readysetstem/readysetstem-hw-lids/HeaderConnectorBoard/board-bottom.jpg

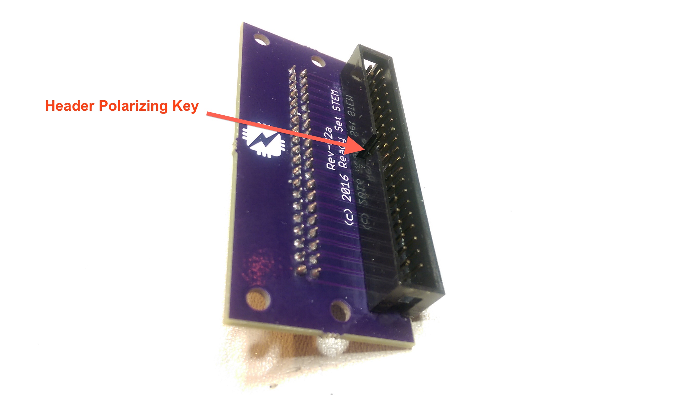
HeaderConnectorBoard/board-bottom.jpg
