readysetstem/readysetstem-hw-lids/HeaderConnectorBoard/board-top.jpg

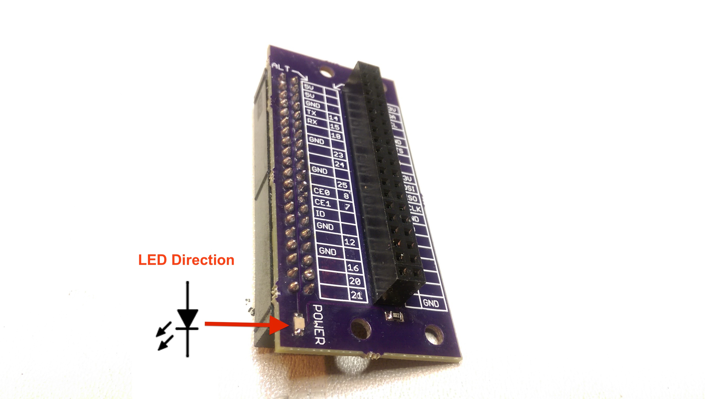
HeaderConnectorBoard/board-top.jpg
