readysetstem/readysetstem-hw-lids/README.md

readysetstem-hw-lids
===========================

Ready Set STEM(TM) Lids hardware schematics and related documents
