readysetstem/readysetstem-hw-lids/MiniConnectorBoard/README.txt

FILE LIST

gerbers/*.GKO       Outline
gerbers/*.GBL       Bottom Copper
gerbers/*.GBO       Bottom Silkscreen
gerbers/*.GBP       Bottom Paste
gerbers/*.GBS       Bottom Soldermask
gerbers/*.GTL       Top Copper
gerbers/*.GTO       Top Silkscreen
gerbers/*.GTP       Top Paste
gerbers/*.GTS       Top Soldermask
gerbers/*.GML       Mill Layer
gerbers/*.TXT       Drill File
gerbers/*.dri       Drill Station Info File
gerbers/*.gpi       Photoplotter Info File   
*.brd               EagleCAD Board File
*.lbr               EagleCAD Library File
*.sch               EagleCAD Schematic File
*_BOM.xls           BOM
README.txt          This file
*.jpg               Reference images

Gerber Files Generated from EagleCAD 7.6 CAM Processor using sfe-gerb274x.cam

GENERAL NOTES

- Refer to the JPG images for through-hole part orientation.
- All parts and assembly should be Lead-Free RoHS compliant
- Any manufacturer information added to silkscreen should be on bottom side of
  board only.

BOARD SPECS

Material                FR4
Board Thickness         62 mils
Layers                  2
Copper thickness        1 oz.
Silkscreen color        white
Soldermask color        green
Finish                  Lead Free HASL or ENIG
Panelization            V-cut

CONTACT INFO

Name                    Brian Silverman or Jason Steinhorn
Company                 Ready Set STEM
Email                   bri@readysetstem.com or j@readysetstem.com
