readysetstem/readysetstem-hw-lids/MiniConnectorBoard/MiniConnectorBoard_BOM.xls

Item | Qty | Reference Designators | Internal Part # | Manufacturer | Manufacturer Part # | Digikey Part # | Value | Package | Description
1 | 1 | JP1 | rs06036 | Sullins Connector Solutions | PPTC202LFBN-RC | S6104-ND | NA | Thru hole | CONN HEADER FEM 40POS .1" DL TIN
2 | 2 | JP2 JP3 | rs06033 | Sullins Connector Solutions | PPTC201LFBN-RC | S7018-ND | NA | Thru hole | CONN HEADER FEMALE 20POS.1" TIN
