readysetstem/readysetstem-hw-lids/Gamer/Gamer_BOM.xls

Item | Qty | Reference Designators | Internal Part # | Manufacturer | Manufacturer Part # | Digikey Part # | Value | Package | Description
1 | 8 | J1 J2 J3 J4 J5 J6 J7 J8 | rs06057 | Sullins | PPTC081LFBN-RC | S7006-ND |  | Thru hole | CONN HEADER FEMALE 8POS .1" TIN
2 | 4 | R1 R2 R3 R4 R5 R6 | rs06006 | Yageo | RC0603JR-0710KL | 311-10KGRCT-ND | 10kohms | 0603 | RES SMD 10K OHM 5% 1/10W 0603
3 | 4 | U2 U4 U6 U8 | rs06053 | Atmel | ATTINY48-AUR | ATTINY48-AURCT-ND |  | 32-TQFP | IC MCU 8BIT 4KB FLASH 32TQFP
4 | 4 | U3 U5 U7 U9 | rs06052 | Toshiba Semiconductor | ULN2803AFWG,C,EL | ULN2803AFWGCELTR-ND |  | 18-SOIC | TRANS 8NPN DARL 50V 0.5A 18SOL
5 | 1 | U1 | rs06007 | Freescale Semiconductor | MMA8653FCR1 | MMA8653FCR1TR-ND |  | 10-VFDFN | IC ACCELEROMETER 3AXIS 10DFN
7 | 3 | C1 C3 C4 | rs06004 | Murata | GRM188R71C104KA01D | 490-1532-1-ND | 0.1µF | 0603 | CAP CER 0.1UF 16V 10% X7R 0603
8 | 1 | C2 C5 C6 C7 C8 | rs06005 | Murata | GRM188R61A105KA61D | 490-1543-1-ND | 1µF | 0603 | CAP CER 1UF 10V 10% X5R 0603
9 | 1 | J9 | rs06037 | On Shore Technology Inc | 302-S401 | ED10529-ND |  | Thru hole | CONN HEADER VERT 40POS GOLD
10 | 6 | B3 B4 B5 B6 B7 B8 | rs04017 | E-Switch | TL3300DF260Q | EG4907CT-ND |  | SMD | SWITCH TACTILE SPST-NO 0.05A 12V
11 | 2 | B1 B2 | rs04016 | C&K Components | PTS645SK43SMTR92 LFS | CKN9084CT-ND |  | SMD | SWITCH TACTILE SPST-NO 0.05A 12V
