readysetstem/readysetstem-hw-lids/MiniConnectorBoard/MiniConnectorBoard.brd

## EAGLE design MiniConnectorBoard/MiniConnectorBoard.brd (2016-09-28)

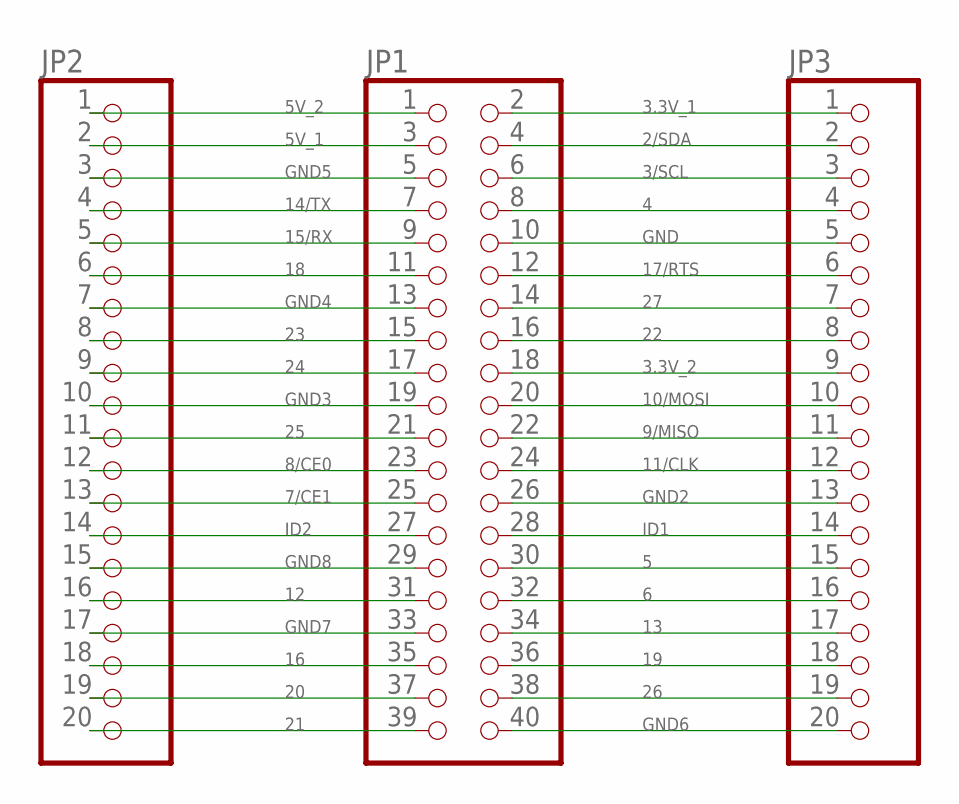
[picture p3: schematic MiniConnectorBoard.sch]

Parts:
JP1: NONE; 2X20
JP2, JP3: NONE; 1X20

Connections:
2/SDA: JP1.4, JP3.2
3.3V_1: JP1.2, JP3.1
3.3V_2: JP1.18, JP3.9
3/SCL: JP1.6, JP3.3
4: JP1.8, JP3.4
5: JP1.30, JP3.15
5V_1: JP1.3, JP2.2
5V_2: JP1.1, JP2.1
6: JP1.32, JP3.16
7/CE1: JP1.25, JP2.13
8/CE0: JP1.23, JP2.12
9/MISO: JP1.22, JP3.11
10/MOSI: JP1.20, JP3.10
11/CLK: JP1.24, JP3.12
12: JP1.31, JP2.16
13: JP1.34, JP3.17
14/TX: JP1.7, JP2.4
15/RX: JP1.9, JP2.5
16: JP1.35, JP2.18
17/RTS: JP1.12, JP3.6
18: JP1.11, JP2.6
19: JP1.36, JP3.18
20: JP1.37, JP2.19
21: JP1.39, JP2.20
22: JP1.16, JP3.8
23: JP1.15, JP2.8
24: JP1.17, JP2.9
25: JP1.21, JP2.11
26: JP1.38, JP3.19
27: JP1.14, JP3.7
GND: JP1.10, JP3.5
GND2: JP1.26, JP3.13
GND3: JP1.19, JP2.10
GND4: JP1.13, JP2.7
GND5: JP1.5, JP2.3
GND6: JP1.40, JP3.20
GND7: JP1.33, JP2.17
GND8: JP1.29, JP2.15
ID1: JP1.28, JP3.14
ID2: JP1.27, JP2.14

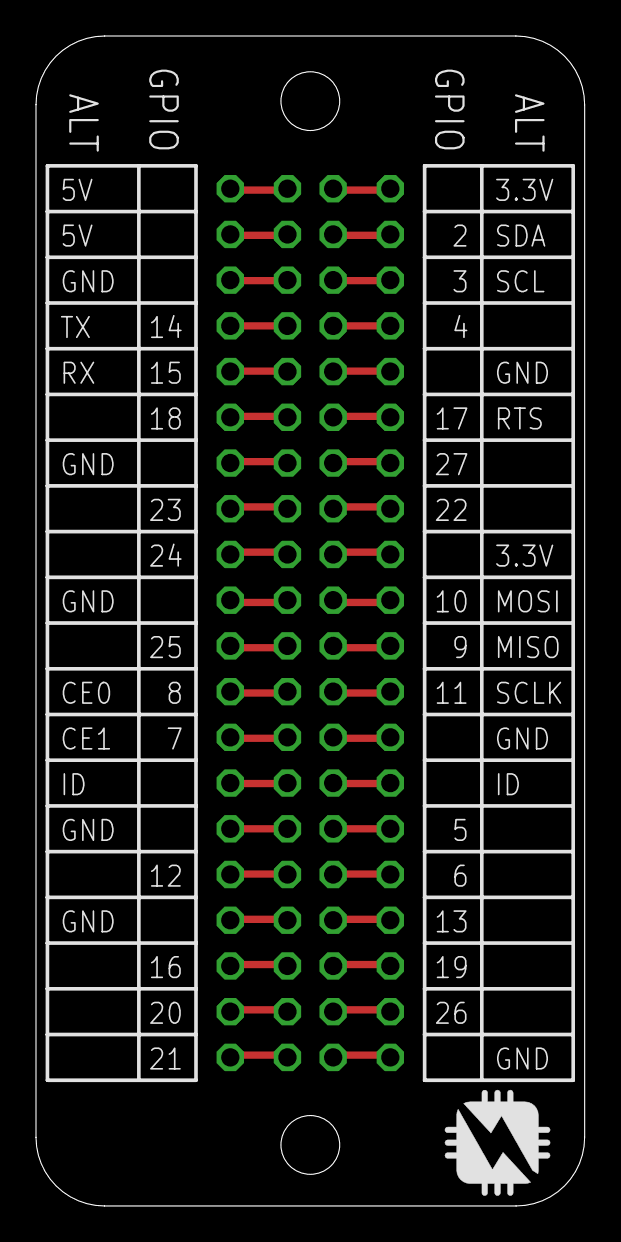
[picture p4: board MiniConnectorBoard.brd from above]

Board: 2 copper layers, 30.5 x 65.0 mm, 3 parts (0 on the bottom side), 40 nets.
