readysetstem/readysetstem-hw-lids/Gamer/Gamer.brd

## EAGLE design Gamer/Gamer.brd (2015-05-13)

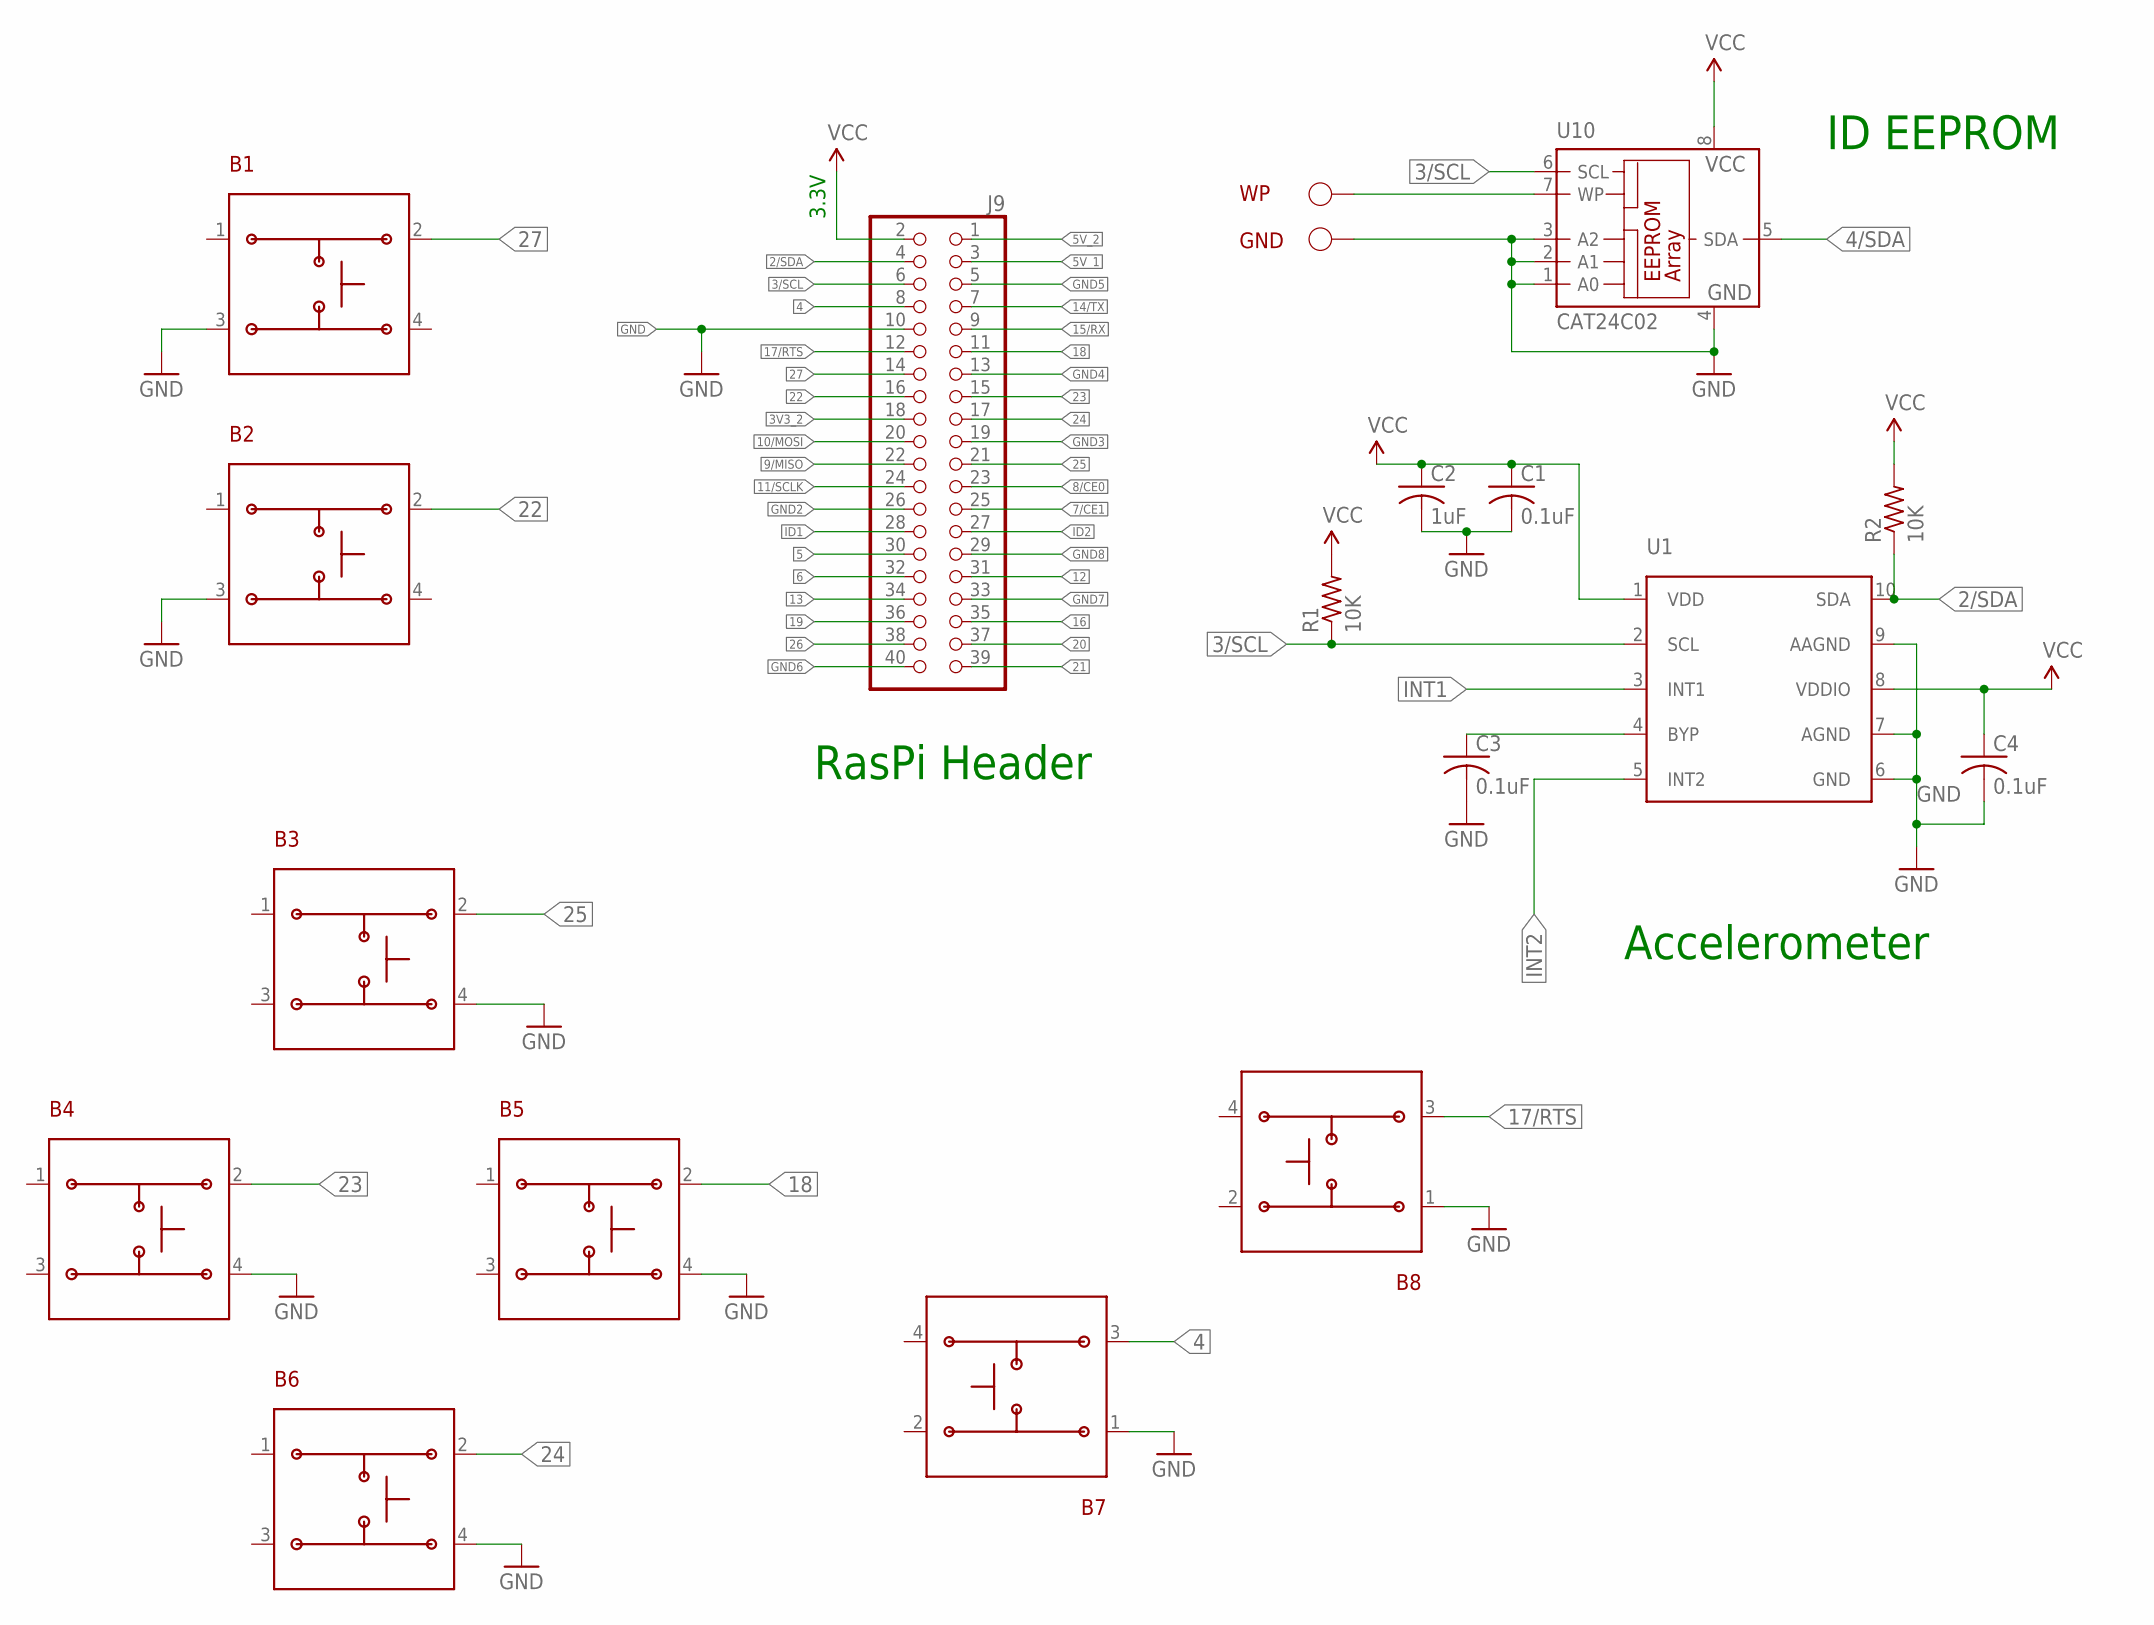
[picture p5: schematic Gamer.sch, sheet 1]

Parts:
B1, B2: 6X6MM_BUTTON
B3, B4, B5, B6, B7, B8: 12X12MM_BUTTON
C1, C3, C4: 0.1uF; C0603
C2: 1uF; C0603
GND: TESTPAD
J9: PINHD-2X20; 2X20
R1, R2: 10K; R0603
U1: MMA8653FCR1
U10: CAT24C02; TSSOP8
WP: TESTPAD

Connections:
2/SDA: J9.4, R2.1, U1.10 (SDA)
3/SCL: J9.6, R1.1, U1.2 (SCL), U10.6 (SCL)
3V3_2: J9.18
4: B7.3, J9.8
4/SDA: U10.5 (SDA)
5: J9.30
5V_1: J9.3
5V_2: J9.1
6: J9.32
7/CE1: J9.25
8/CE0: J9.23; also elsewhere on the board
9/MISO: J9.22; also elsewhere on the board
10/MOSI: J9.20; also elsewhere on the board
11/SCLK: J9.24; also elsewhere on the board
12: J9.31
13: J9.34
14/TX: J9.7
15/RX: J9.9
16: J9.35
17/RTS: B8.3, J9.12
18: B5.2, J9.11
19: J9.36
20: J9.37
21: J9.39
22: B2.2, J9.16
23: B4.2, J9.15
24: B6.2, J9.17
25: B3.2, J9.21
26: J9.38
27: B1.2, J9.14
GND: B1.3, B2.3, B3.4, B4.4, B5.4, B6.4, B7.1, B8.1, C1.2, C2.2, C3.2, C4.2, GND.1, J9.10, U1.6 (GND), U1.7 (AGND), U1.9 (AAGND), U10.1 (A0), U10.2 (A1), U10.3 (A2), U10.4 (GND); also elsewhere on the board
GND2: J9.26
GND3: J9.19
GND4: J9.13
GND5: J9.5
GND6: J9.40
GND7: J9.33
GND8: J9.29
ID1: J9.28
ID2: J9.27
INT1: U1.3 (INT1)
INT2: U1.5 (INT2)
unnamed: U10.7 (WP), WP.1
unnamed: C3.1, U1.4 (BYP)
VCC: C1.1, C2.1, C4.1, J9.2, R1.2, R2.2, U1.1 (VDD), U1.8 (VDDIO), U10.8 (VCC); also elsewhere on the board

Notes on the sheet:
RasPi Header
Accelerometer
3.3V
ID EEPROM

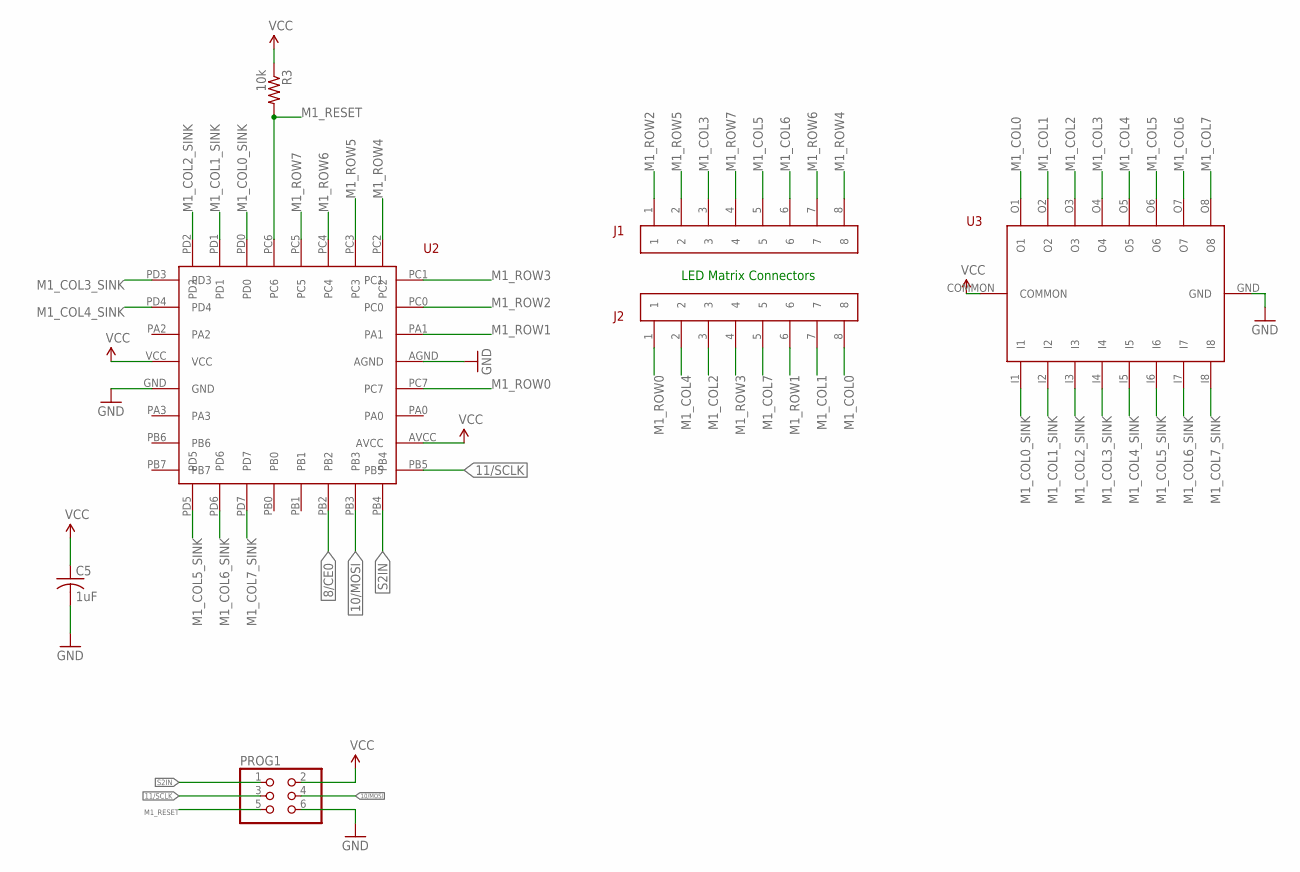
[picture p6: schematic Gamer.sch, sheet 2]

Parts:
C5: 1uF; C0603
J1, J2: HEADER-1X8
PROG1: NONE; 2X03
R3: 10k; R0603
U2: ATTINY48
U3: ULN2803AFWG

Connections:
8/CE0: U2.PB2; also elsewhere on the board
10/MOSI: PROG1.4, U2.PB3; also elsewhere on the board
11/SCLK: PROG1.3, U2.PB5; also elsewhere on the board
GND: C5.2, PROG1.6, U2.AGND, U2.GND, U3.GND; also elsewhere on the board
M1_COL0: J2.8, U3.O1
M1_COL0_SINK: U2.PD0, U3.I1
M1_COL1: J2.7, U3.O2
M1_COL1_SINK: U2.PD1, U3.I2
M1_COL2: J2.3, U3.O3
M1_COL2_SINK: U2.PD2, U3.I3
M1_COL3: J1.3, U3.O4
M1_COL3_SINK: U2.PD3, U3.I4
M1_COL4: J2.2, U3.O5
M1_COL4_SINK: U2.PD4, U3.I5
M1_COL5: J1.5, U3.O6
M1_COL5_SINK: U2.PD5, U3.I6
M1_COL6: J1.6, U3.O7
M1_COL6_SINK: U2.PD6, U3.I7
M1_COL7: J2.5, U3.O8
M1_COL7_SINK: U2.PD7, U3.I8
M1_RESET: PROG1.5, R3.2, U2.PC6
M1_ROW0: J2.1, U2.PC7
M1_ROW1: J2.6, U2.PA1
M1_ROW2: J1.1, U2.PC0
M1_ROW3: J2.4, U2.PC1
M1_ROW4: J1.8, U2.PC2
M1_ROW5: J1.2, U2.PC3
M1_ROW6: J1.7, U2.PC4
M1_ROW7: J1.4, U2.PC5
S2IN: PROG1.1, U2.PB4; also elsewhere on the board
VCC: C5.1, PROG1.2, R3.1, U2.AVCC, U2.VCC, U3.COMMON; also elsewhere on the board

Notes on the sheet:
LED Matrix Connectors

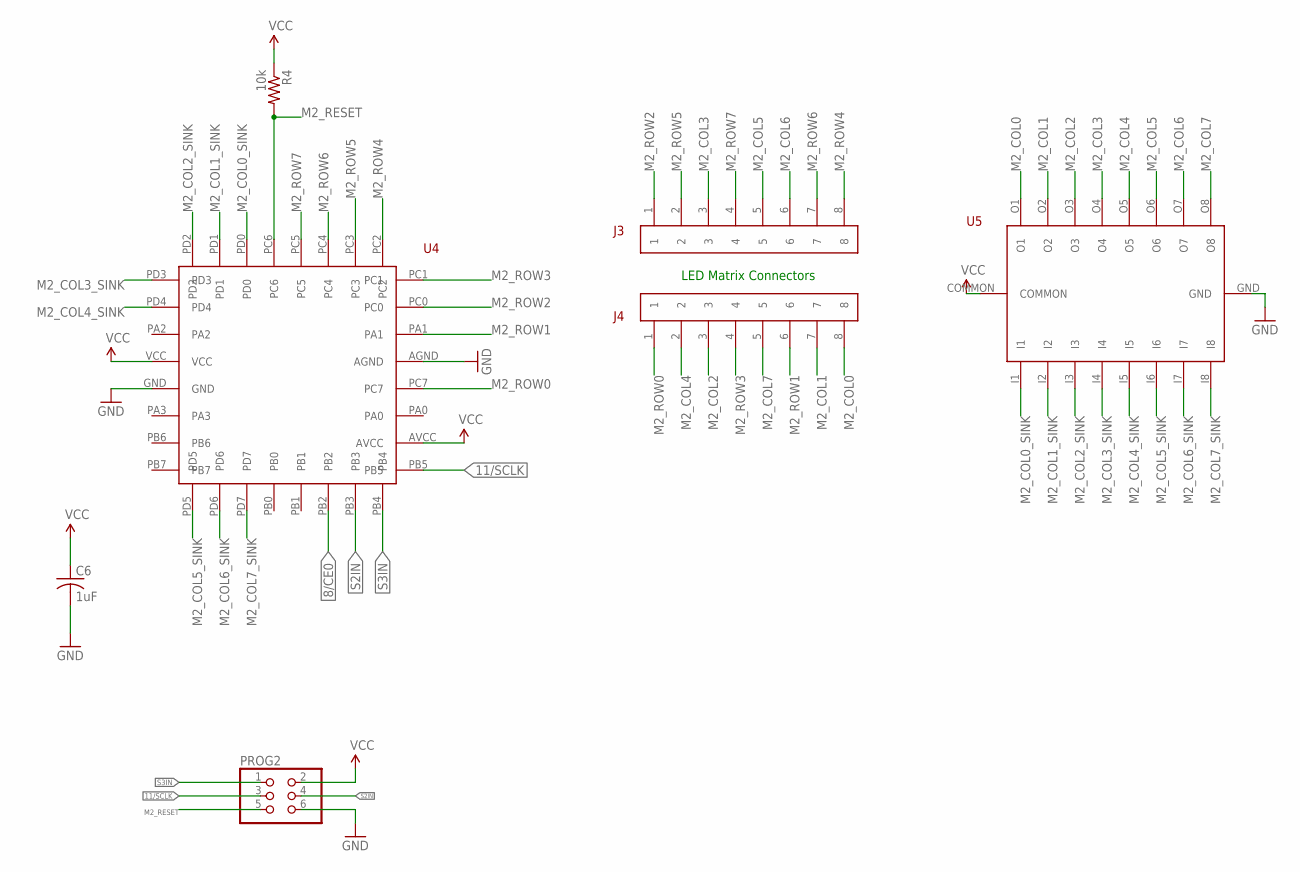
[picture p7: schematic Gamer.sch, sheet 3]

Parts:
C6: 1uF; C0603
J3, J4: HEADER-1X8
PROG2: NONE; 2X03
R4: 10k; R0603
U4: ATTINY48
U5: ULN2803AFWG

Connections:
8/CE0: U4.PB2; also elsewhere on the board
11/SCLK: PROG2.3, U4.PB5; also elsewhere on the board
GND: C6.2, PROG2.6, U4.AGND, U4.GND, U5.GND; also elsewhere on the board
M2_COL0: J4.8, U5.O1
M2_COL0_SINK: U4.PD0, U5.I1
M2_COL1: J4.7, U5.O2
M2_COL1_SINK: U4.PD1, U5.I2
M2_COL2: J4.3, U5.O3
M2_COL2_SINK: U4.PD2, U5.I3
M2_COL3: J3.3, U5.O4
M2_COL3_SINK: U4.PD3, U5.I4
M2_COL4: J4.2, U5.O5
M2_COL4_SINK: U4.PD4, U5.I5
M2_COL5: J3.5, U5.O6
M2_COL5_SINK: U4.PD5, U5.I6
M2_COL6: J3.6, U5.O7
M2_COL6_SINK: U4.PD6, U5.I7
M2_COL7: J4.5, U5.O8
M2_COL7_SINK: U4.PD7, U5.I8
M2_RESET: PROG2.5, R4.2, U4.PC6
M2_ROW0: J4.1, U4.PC7
M2_ROW1: J4.6, U4.PA1
M2_ROW2: J3.1, U4.PC0
M2_ROW3: J4.4, U4.PC1
M2_ROW4: J3.8, U4.PC2
M2_ROW5: J3.2, U4.PC3
M2_ROW6: J3.7, U4.PC4
M2_ROW7: J3.4, U4.PC5
S2IN: PROG2.4, U4.PB3; also elsewhere on the board
S3IN: PROG2.1, U4.PB4; also elsewhere on the board
VCC: C6.1, PROG2.2, R4.1, U4.AVCC, U4.VCC, U5.COMMON; also elsewhere on the board

Notes on the sheet:
LED Matrix Connectors

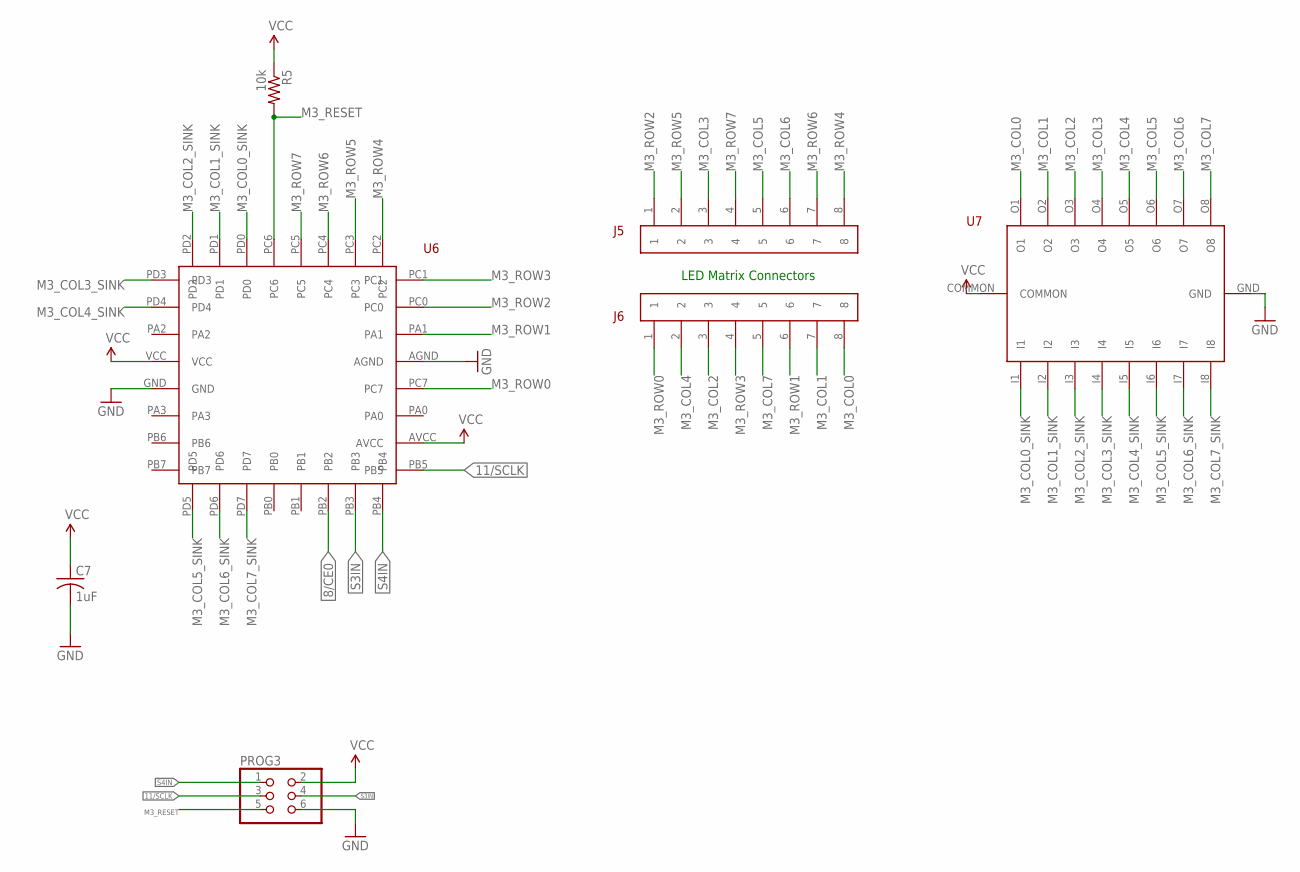
[picture p8: schematic Gamer.sch, sheet 4]

Parts:
C7: 1uF; C0603
J5, J6: HEADER-1X8
PROG3: NONE; 2X03
R5: 10k; R0603
U6: ATTINY48
U7: ULN2803AFWG

Connections:
8/CE0: U6.PB2; also elsewhere on the board
11/SCLK: PROG3.3, U6.PB5; also elsewhere on the board
GND: C7.2, PROG3.6, U6.AGND, U6.GND, U7.GND; also elsewhere on the board
M3_COL0: J6.8, U7.O1
M3_COL0_SINK: U6.PD0, U7.I1
M3_COL1: J6.7, U7.O2
M3_COL1_SINK: U6.PD1, U7.I2
M3_COL2: J6.3, U7.O3
M3_COL2_SINK: U6.PD2, U7.I3
M3_COL3: J5.3, U7.O4
M3_COL3_SINK: U6.PD3, U7.I4
M3_COL4: J6.2, U7.O5
M3_COL4_SINK: U6.PD4, U7.I5
M3_COL5: J5.5, U7.O6
M3_COL5_SINK: U6.PD5, U7.I6
M3_COL6: J5.6, U7.O7
M3_COL6_SINK: U6.PD6, U7.I7
M3_COL7: J6.5, U7.O8
M3_COL7_SINK: U6.PD7, U7.I8
M3_RESET: PROG3.5, R5.2, U6.PC6
M3_ROW0: J6.1, U6.PC7
M3_ROW1: J6.6, U6.PA1
M3_ROW2: J5.1, U6.PC0
M3_ROW3: J6.4, U6.PC1
M3_ROW4: J5.8, U6.PC2
M3_ROW5: J5.2, U6.PC3
M3_ROW6: J5.7, U6.PC4
M3_ROW7: J5.4, U6.PC5
S3IN: PROG3.4, U6.PB3; also elsewhere on the board
S4IN: PROG3.1, U6.PB4; also elsewhere on the board
VCC: C7.1, PROG3.2, R5.1, U6.AVCC, U6.VCC, U7.COMMON; also elsewhere on the board

Notes on the sheet:
LED Matrix Connectors

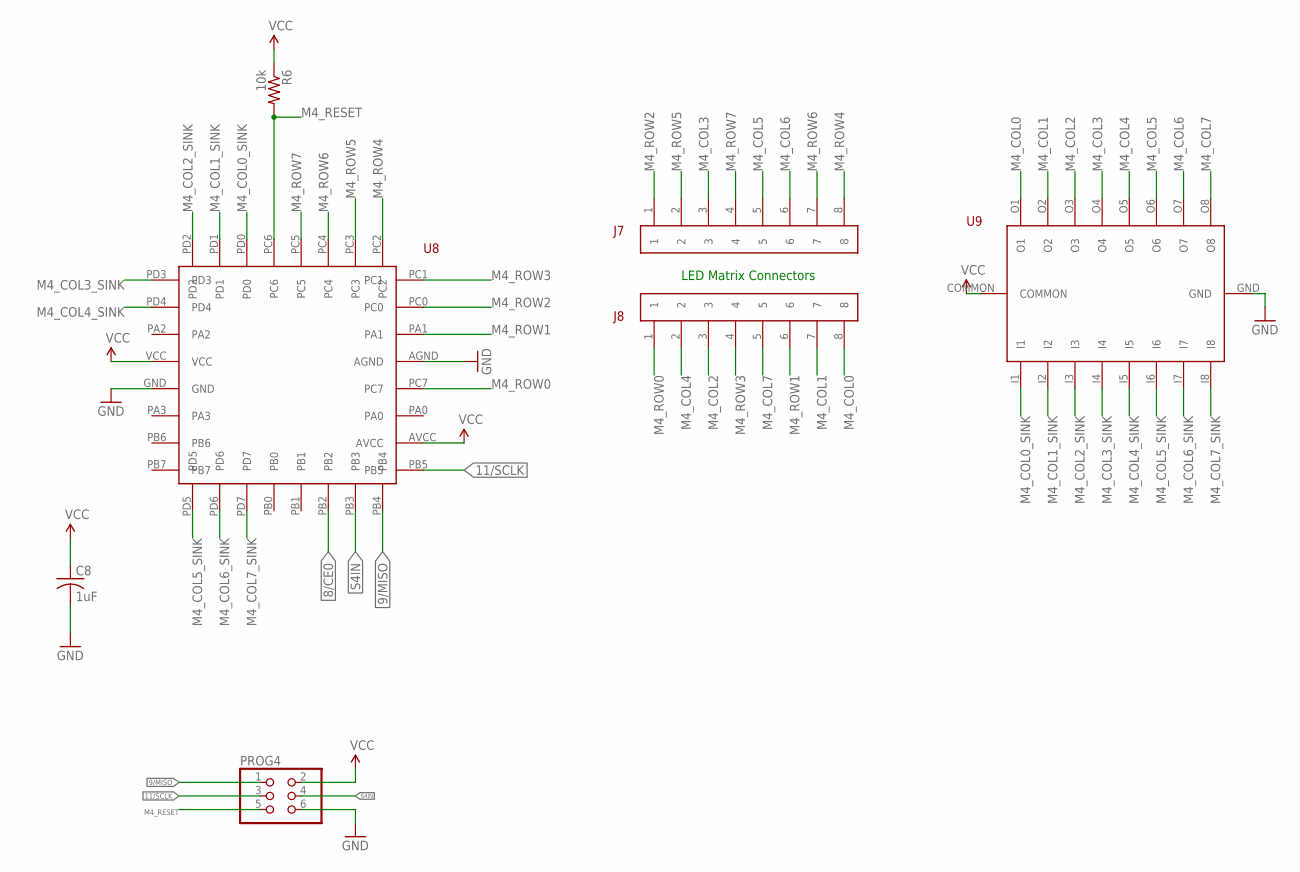
[picture p9: schematic Gamer.sch, sheet 5]

Parts:
C8: 1uF; C0603
J7, J8: HEADER-1X8
PROG4: NONE; 2X03
R6: 10k; R0603
U8: ATTINY48
U9: ULN2803AFWG

Connections:
8/CE0: U8.PB2; also elsewhere on the board
9/MISO: PROG4.1, U8.PB4; also elsewhere on the board
11/SCLK: PROG4.3, U8.PB5; also elsewhere on the board
GND: C8.2, PROG4.6, U8.AGND, U8.GND, U9.GND; also elsewhere on the board
M4_COL0: J8.8, U9.O1
M4_COL0_SINK: U8.PD0, U9.I1
M4_COL1: J8.7, U9.O2
M4_COL1_SINK: U8.PD1, U9.I2
M4_COL2: J8.3, U9.O3
M4_COL2_SINK: U8.PD2, U9.I3
M4_COL3: J7.3, U9.O4
M4_COL3_SINK: U8.PD3, U9.I4
M4_COL4: J8.2, U9.O5
M4_COL4_SINK: U8.PD4, U9.I5
M4_COL5: J7.5, U9.O6
M4_COL5_SINK: U8.PD5, U9.I6
M4_COL6: J7.6, U9.O7
M4_COL6_SINK: U8.PD6, U9.I7
M4_COL7: J8.5, U9.O8
M4_COL7_SINK: U8.PD7, U9.I8
M4_RESET: PROG4.5, R6.2, U8.PC6
M4_ROW0: J8.1, U8.PC7
M4_ROW1: J8.6, U8.PA1
M4_ROW2: J7.1, U8.PC0
M4_ROW3: J8.4, U8.PC1
M4_ROW4: J7.8, U8.PC2
M4_ROW5: J7.2, U8.PC3
M4_ROW6: J7.7, U8.PC4
M4_ROW7: J7.4, U8.PC5
S4IN: PROG4.4, U8.PB3; also elsewhere on the board
VCC: C8.1, PROG4.2, R6.1, U8.AVCC, U8.VCC, U9.COMMON; also elsewhere on the board

Notes on the sheet:
LED Matrix Connectors

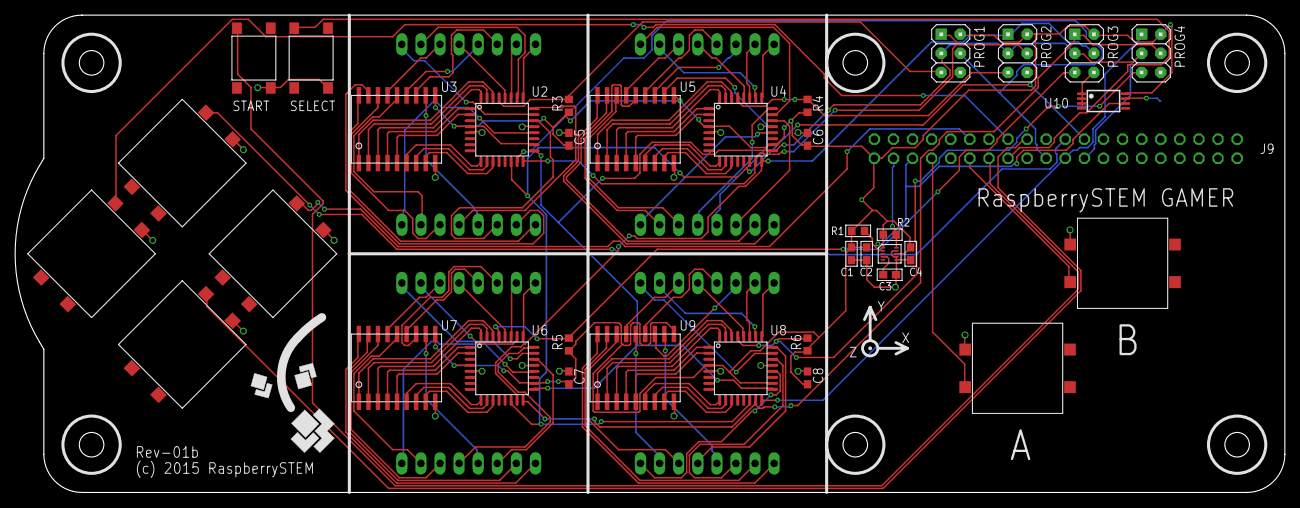
[picture p10: board Gamer.brd from above]

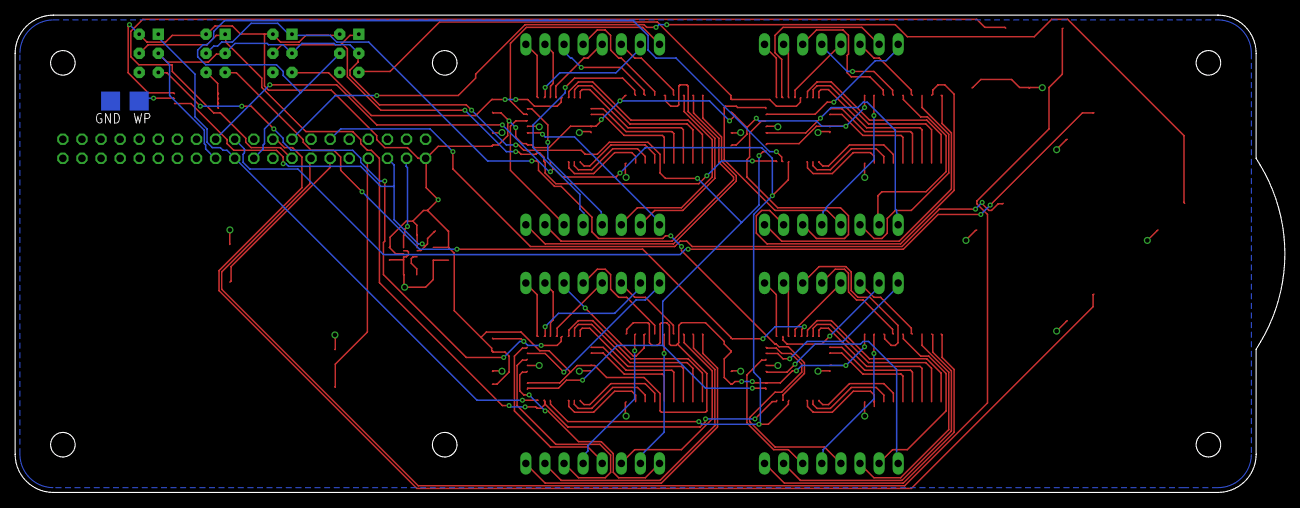
[picture p11: board Gamer.brd from below]

Board: 2 copper layers, 168.9 x 63.5 mm, 47 parts (3 on the bottom side), 121 nets.
