readysetstem/readysetstem-hw-lids/HeaderConnectorBoard/HeaderConnectorBoard.brd

## EAGLE design HeaderConnectorBoard/HeaderConnectorBoard.brd (2016-09-28)

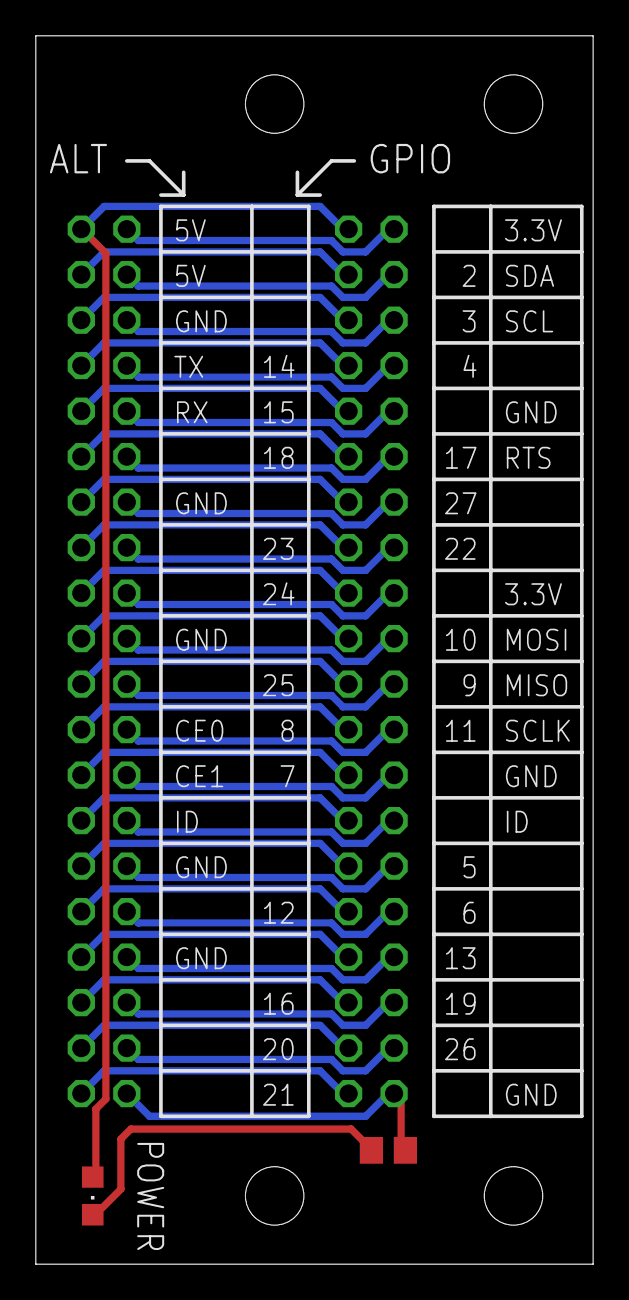
[picture p12: board HeaderConnectorBoard.brd from above]

Board: 2 copper layers, 31.1 x 68.6 mm, 4 parts (0 on the bottom side), 41 nets.

Parts:
JP1, JP2: NONE; 2X20
LED1: 475-1410-2-ND; CHIPLED_0805
R1: 200; R0805

Connections:
2/SDA: JP1.4, JP2.4
3.3V_1: JP1.2, JP2.2
3.3V_2: JP1.18, JP2.18
3/SCL: JP1.6, JP2.6
4: JP1.8, JP2.8
5: JP1.30, JP2.30
5V_1: JP1.3, JP2.3
5V_2: JP1.1, JP2.1, LED1.A
6: JP1.32, JP2.32
7/CE1: JP1.25, JP2.25
8/CE0: JP1.23, JP2.23
9/MISO: JP1.22, JP2.22
10/MOSI: JP1.20, JP2.20
11/CLK: JP1.24, JP2.24
12: JP1.31, JP2.31
13: JP1.34, JP2.34
14/TX: JP1.7, JP2.7
15/RX: JP1.9, JP2.9
16: JP1.35, JP2.35
17/RTS: JP1.12, JP2.12
18: JP1.11, JP2.11
19: JP1.36, JP2.36
20: JP1.37, JP2.37
21: JP1.39, JP2.39
22: JP1.16, JP2.16
23: JP1.15, JP2.15
24: JP1.17, JP2.17
25: JP1.21, JP2.21
26: JP1.38, JP2.38
27: JP1.14, JP2.14
GND: JP1.10, JP2.10
GND2: JP1.26, JP2.26
GND3: JP1.19, JP2.19
GND4: JP1.13, JP2.13
GND5: JP1.5, JP2.5
GND6: JP1.40, JP2.40, R1.1
GND7: JP1.33, JP2.33
GND8: JP1.29, JP2.29
ID1: JP1.28, JP2.28
ID2: JP1.27, JP2.27
unnamed: LED1.C, R1.2
