readysetstem/readysetstem-hw-lids/(commit log)

2014-06-26 Added BOM for header PCB
    [Header.brd, Header.sch, Header.xls]
2014-07-18 Fixed 5V text misalignment
    [Header.brd]
2014-07-22 Removed bottom layer silk screen
    [Header.brd, Header.sch]
2014-07-22 Added matrix brd and sch
    [Matrix_Game_Board.brd, Matrix_Game_Board.sch]
2014-07-22 Added files to folder Matrix_Game_Board
    [Matrix_Game_Board.brd, Matrix_Game_Board.sch]
2014-07-25 Shifted text to not be blocked by header
    [Header.brd]
2014-07-25 Added start and select buttons to matrix board and moved accelerometer to the middle of the board
    [Matrix_Game_Board.brd, Matrix_Game_Board.sch]
2014-07-25 Corrected some net names on Gamer PCB
    [Matrix_Game_Board.brd, Matrix_Game_Board.sch]
2014-07-25 Corrected some more net names on Gamer PCB
    [Matrix_Game_Board.brd, Matrix_Game_Board.sch]
2014-07-25 Changed resistors to 0603 on gamer PCB
    [Matrix_Game_Board.brd, Matrix_Game_Board.sch]
2014-08-01 Moved start and select, moved pi header down to make screws in 2x6in square
    [Matrix_Game_Board.brd]
2014-08-07 Changed to right angle headers for power and speaker
    [Matrix_Game_Board.brd]
2014-08-15 Inverted bottom row of matrices, routed CS, added ground plane
    [Matrix_Game_Board.brd, Matrix_Game_Board.sch]
2014-08-28 Moved buttons down, moved large capacitor to top of board
    [Matrix_Game_Board.brd]
2014-12-30 renamed LargeHeader -> HeaderConnectorBoard
    [Header.xls, HeaderConnectorBoard.brd, HeaderConnectorBoard.sch]
2014-12-30 Model A/B Plus compatibility with major simplification
    Simplified header connetor to ONLY be a Raspberry Pi header connectorizer -
    that is, it no longer takes speaker or audio (or the now deprecated USB power
    adapter). Speaker and audio will be handled with simpler cables to the
    breadboard. So, now the header only has 2 connectors: a header to the RasPi,
    and a header for breadboard connections.
    Also, a total redo of the labeling to have a much more clear grid layout,
    separatating GPIO pin numbers from alternate pin functions.
    [Header.xls, HeaderConnectorBoard.brd]
2015-01-04 HeaderConnectorBoard - Increased font size of some labels
    [HeaderConnectorBoard.brd]
2015-01-04 HeaderConnectorBoard - Adjust font sizes/type
    [HeaderConnectorBoard.brd]
2015-01-22 lid connector - changed size and mounting for top mounting on lid
    New connector board will be mounted on top (used to be bottom) of RaspberrySTEM
    Lid, with an extra arcrylic spacer in between.
    [HeaderConnectorBoard.brd, HeaderConnectorBoard.sch]
2015-01-22 lic connector - adjustments to fit with acrylic
    [HeaderConnectorBoard.brd]
2015-01-22 lid connector - moved/rotated logo
    It previously overlapped with one of the headers.
    [HeaderConnectorBoard.brd]
2015-01-22 lid connector - added ALT/GPIO labelling
    [HeaderConnectorBoard.brd]
2015-02-20 lid connector - Readjust mounting holes. Rev-01a.
    adjustments to allow screw head clearance for board headers, and to clear silkscreen.
    [HeaderConnectorBoard.brd]
2015-03-19 lid connector - BOM
    [HeaderConnectorBoard_BOM.xls]
2015-03-20 gamer - preliminary BOM
    [Matrix_Game_Board_BOM.xls]
2015-04-10 Gamer - Rename Gamer board
    [Gamer.brd, Gamer.sch, Gamer_BOM.xls]
2015-04-14 gamer - Starting complete redo of Gamer
    [Gamer.brd, Gamer.sch]
2015-04-15 lid connector - created gerbers
    [HeaderConnectorBoard.GBL, HeaderConnectorBoard.GBO, HeaderConnectorBoard.GBS, HeaderConnectorBoard.GTL, HeaderConnectorBoard.GTO, HeaderConnectorBoard.GTP, HeaderConnectorBoard.GTS]
2015-04-15 lid conn - Added board fab notes images
2015-04-15 PCBs - Added gitignores
2015-04-15 gamer - Work in progress
    [Gamer.brd, Gamer.sch]
2015-04-16 gamer - Duplicated matrices (not laid out)
    [Gamer.brd, Gamer.sch]
2015-04-16 gamer - intial layout of all matrix parts
    [Gamer.brd]
2015-04-16 gamer - rejiggered PROG connectors
    [Gamer.brd, Gamer.sch]
2015-04-16 gamer - properly chained MISO/MOSI through LED matrices
    [Gamer.brd, Gamer.sch]
2015-04-16 gamer - fully routed, first attempt
    Will need to be rerouted, if middle mounting holes are added.
    [Gamer.brd]
2015-04-17 gamer - partial routing, with ground plane and vias, and some hand routing
    [Gamer.brd, Gamer.sch]
2015-04-17 gamer - more manual routing
    [Gamer.brd, Gamer.sch]
2015-04-17 gamer - hand route accelerometer
    [Gamer.brd]
2015-04-17 gamer - auto route 100%
    [Gamer.brd]
2015-04-17 gamer - Added logo and other text
    [Gamer.brd]
2015-04-17 gamer - Moved text that conflicted with stop mask
    [Gamer.brd]
2015-04-17 gamer - Order of SPI chain was backwards
    [Gamer.brd, Gamer.sch]
2015-04-17 gamer - ERC passes (with many okay warnings)
    [Gamer.brd, Gamer.sch]
2015-04-17 gamer - Rerouted 100%
    [Gamer.brd]
2015-04-18 gamer - main header was flipped. Flipped and rerouted 100%.
    [Gamer.brd]
2015-05-04 gamer - first new protoype fixes... Unrouted.
    - RaspberrySTEM GAMER name obscured by header
    - mounting holes
    - header pins flipped
    [Gamer.brd, Gamer.sch]
2015-05-04 gamer - rerouted. remasked mounting holes around bottom gnd plane
    [Gamer.brd]
2015-05-05 gamer - rev up, added accel silkscreen, other fixes
    [Gamer.brd, Gamer.sch]
2015-05-05 gamer - updated BOM and silkscreen
    [Gamer.brd, Gamer.sch, Gamer_BOM.xls]
2015-05-05 gamer - added gerbers
    [Gamer.GBL, Gamer.GBO, Gamer.GBS, Gamer.GTL, Gamer.GTO, Gamer.GTP, Gamer.GTS]
2015-05-13 gamer - Added EEPROM, unplaced and unrouted.
    [Gamer.brd, Gamer.sch]
2015-05-13 gamer - eeprom placed and routed
    [Gamer.brd]
2016-08-05 Lid Conn - Updated versions and product name
    [HeaderConnectorBoard.brd]
2016-08-05 Lid conn - added POWER LED
    [HeaderConnectorBoard.brd, HeaderConnectorBoard.sch, HeaderConnectorBoard_BOM.xls]
2016-08-05 Lid conn - RaspSTEM logo -> Ready Set STEM logo
    [HeaderConnectorBoard.brd]
2016-08-08 updtaed gerbers
    [HeaderConnectorBoard.GBL, HeaderConnectorBoard.GBO, HeaderConnectorBoard.GBP, HeaderConnectorBoard.GBS, HeaderConnectorBoard.GKO, HeaderConnectorBoard.GTL, HeaderConnectorBoard.GTO, HeaderConnectorBoard.GTS]
2016-08-20 HeaderConnectorBoard BOM update
    [HeaderConnectorBoard_BOM.xls]
2016-09-07 Lid Conn - updated part numbers
    [HeaderConnectorBoard_BOM.xls]
2016-09-07 lid conn - labels were flipped (and thus power led broken)
    JP1/JP2 had all labelled flipped, which previously was a don't care because the connectors were
    connected straight thru, and no labels were used. When power was added, it was to the wrong pins
    because the labels were wrong. Both are now fixed.
    [HeaderConnectorBoard.brd, HeaderConnectorBoard.sch]
2016-09-13 MiniConnectorBoard - Copied from HeaderConnectorBoard
    [MiniConnectorBoard.GBL, MiniConnectorBoard.GBO, MiniConnectorBoard.GBP, MiniConnectorBoard.GBS, MiniConnectorBoard.GKO, MiniConnectorBoard.GTL, MiniConnectorBoard.GTO, MiniConnectorBoard.GTP]
2016-09-14 MiniConnectorBoard - first cut
    [MiniConnectorBoard.brd, MiniConnectorBoard.sch, MiniConnectorBoard_BOM.xls]
2016-09-14 MiniConnectorBoard - updated gerbers
    [MiniConnectorBoard.GBL, MiniConnectorBoard.GBO, MiniConnectorBoard.GBS, MiniConnectorBoard.GKO, MiniConnectorBoard.GTL, MiniConnectorBoard.GTO, MiniConnectorBoard.GTP, MiniConnectorBoard.GTS]
2016-09-27 HeaderConnectorBoard - updated board-*.jpg photos
2016-09-27 MiniConnectorBoard - added board-*.jpg photos
2016-09-27 HeaderConnectorBoard - removed logo which is not exporting correctly
    Centered copyright. Logo is exporting excessively large in gerbers. Need to fix.
    [HeaderConnectorBoard.brd]
2016-09-28 HeaderConnectorBoard - updated logo
    previous logo was not gerber exportable
    [HeaderConnectorBoard.brd]
2016-09-28 HeaderConnectorBoard - updated gerbers
    [HeaderConnectorBoard.GBL, HeaderConnectorBoard.GBO, HeaderConnectorBoard.GTL, HeaderConnectorBoard.GTO, HeaderConnectorBoard.GTP, HeaderConnectorBoard.GTS]
2016-09-28 HeaderConnectorBoard - Updated board to Rev-02b
    [HeaderConnectorBoard.brd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]
2016-09-28 HeaderConnectorBoard - Added LED part orientation
2016-09-28 MiniConnectorBoard - removed power, added logo, Rev-01b
    [MiniConnectorBoard.brd, MiniConnectorBoard.sch]
2016-09-28 MiniConnectorBoard - updated BOM and annotations
    [MiniConnectorBoard_BOM.xls]
