readysetstem/readysetstem-hw-lids/(notices)

Notices in the files:
HeaderConnectorBoard/HeaderConnectorBoard.brd:
(c) 2016 Ready Set STEM
Gamer/Gamer.brd:
(c) 2015 RaspberrySTEM
parts and their libraries:
SparkFun-Aesthetics: Licensing: Creative Commons ShareAlike 4.0 International - https://creativecommons.org/licenses/by-sa/4.0
